Mohamed-yasser-eisa/healthcare_robotic_arm/Requirement.pdf

### Requirement:

Controlled Robotic Arm mounted on a fixed T-shaped structure.

### THE MAIN TARGERT IS:

Control the robot arm and move it in points (X, Y, Z) in space.

Embedded in the arm an IR temperature sensor + a cavity for a pulse oximeter sensor.

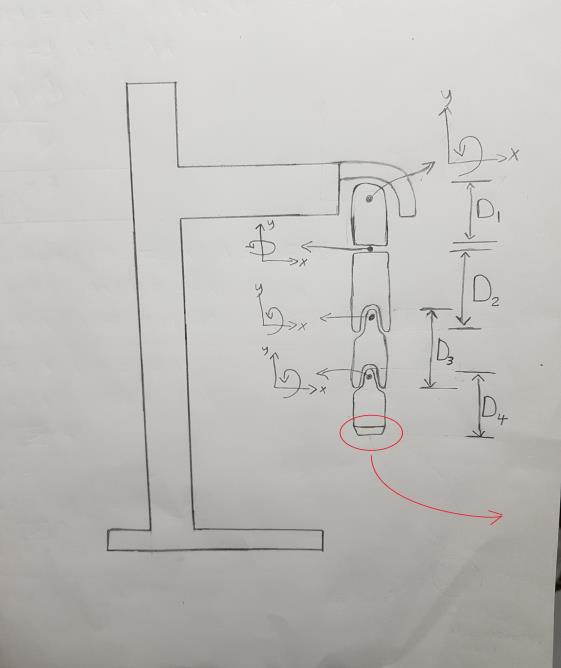
[picture p1: figure]
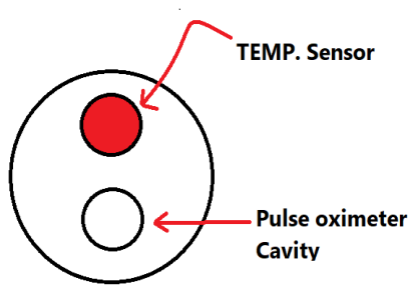
[picture p2: figure]

Robotic Arm | The end of the arm at which the sensors will be embedded.

Suggested total length of the arm is 65 cm:

- Part1: 15 cm
- Part2: 20 cm
- Part3: 15 cm
- Part4: 15 cm

Degree of freedoms:

illustrated in the diagram.

Expected behavior:

The arm is expected to go from point (XA ,YA , ZA ) to point(XB ,YB , ZB ) in space, to illustrate this controlled movement the arm will move to a point where it can take the patient temperature, also we can move the arm to a specific point and then the patient will be asked to put his/her finger in pulse oximeter cavity to take the heart rate reading.
